Phunkafizer/RFID_UP_MODUL/Manual.odt

RFID-UP-Modul

# Schnittstellenbeschreibung

- RS485
- 9600 bit/s
- 8N1

## Frameaufbau

### Layer 1

ESC | SOT | <Layer 2> | CRCLO | CRCHI | ESC | EOT

- Kommt das Zeichen ESC in <FRAMEDATA> vor wird es durch ein zusäzlich eingeschobenes ESC-Zeichen maskiert.
- CRC Berechnung: CCITT 16-Bit CRC, Initwer 0xFFFF, Polynom 0x1021
- Mindestlänge Layer 2: 6 Bytes
- ESC = 0x1B
- SOT = 0x02
- EOT = 0x03

### Layer 2

DESTLO | DESTHI | SRCLO | SRCHI | FRAMEID | ACK | <Layer 3>

DEST LO/HI: Zieladresse

SRC LO/HI: Quelladresse

FRAMEID: Framenummerierung, fortlaufendes Byte

ACK: 0: Frame muss bestätigt werden, 1: Framebestätigung

### Layer 3

CMD | <Parameter>

## Kommandos

Name | Wert | Parameter | Richtung | Beschreibung
CMD_SET_ADR | 0x03 | 2 Bytes Adresse | M→D | Adresse setzten (wenn Modul im Programmiermodus ist)
CMD_SET_PULSE_LEN | 0x04 | 1 Byte Dauer in 1/10 s | M→D | Relaisimpulslänge einstellen
CMD_OPEN_DOOR | 0x10 | 1 Byte Dauer in 1/10 s | M→D | Relais durchschalten
CMD_TAG_REQ | 0x20 | 7 Bytes Tag | D→M | Wird vom Modul geschickt wenn ein Tag eingelesen wurde
CMD_READ_TAG | 0x30 | 2 Byte Index | M→D | Tagspeicher lesen
CMD_READ_TAG_REP | 0x31 | 2 Byte Index 7 Bytes Tag | D→M | Antwort auf Tagspeicher lesen
CMD_WRITE_TAG | 0x40 | 2 Byte Index 7 Bytes Tag | M→D | Tagspeicher schreiben
CMD_ADD_TAG | 0x48 | 7 Bytes Tag | M→D | Tag in Tagspeicher hinzufügen
CMD_IO_EVENT | 0x50 | 1 Byte Event | D→M

# Modulkonfiguration (EEPROM)

Offset | Länge | Beschreibung
0 | 2 Byte | Moduladresse
2 | 1 Byte | Modulmodus
3 | 1 Byte | Schaltdauer in 1/10 s (0 = toggle)
4 | 1 Byte | Relaisflags

## Modulmodi

### Admintag (0xFF)

Im Programmiermodus lässt sich ein Admintag anlernen (dieser öffnet nicht das Relais). Mit dem Admintag wird das Modul in den Anerlnmodus versetzt, mit dem neue Tags hinzugefügt werden können.

### Buttonadd (0x00)

Mit einem kurzen Druck auf den Taster wird das Modul in den Anlernmodus versetzt um neue Tags anzulernen.

### Busmode (0x01)

Hinzufügen von Tags nur über die Schnittstelle möglich.

## Relaisflags

Bit | Funktion
0 | Schaltpolarität
1 | Relais retriggerbar (1 = nein, 0 = ja)
